harris-newsteder/news-kicad-lib/README.md

# news-kicad-lib
NEWSTEDER KiCad Libraries
