harris-newsteder/news-kicad-lib/(commit log)

2019-06-18 added kicad phoenix contact footprints to the newsteder library so I can add 3D models for all the newsteder products that will use the phoenix terminal blocks
2019-06-18 added 3d models for phoenix contact 2 and 4 position terminal blocks 3.5mm pitch
2020-05-09 added new symbols and footprints
2020-05-09 added symbols and footprints
2020-08-23 added MAX current loop protection IC
